thetransistor/OpenWest2017/images/render_back.png

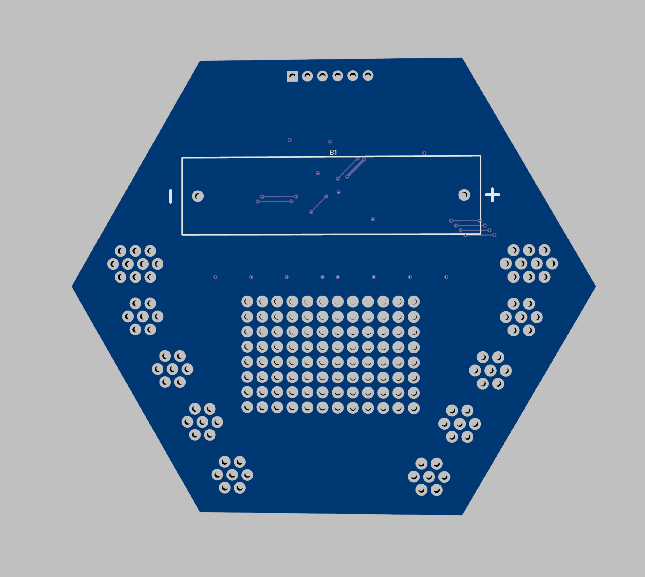
images/render_back.png
