thetransistor/OpenWest2017/images/render_front.png

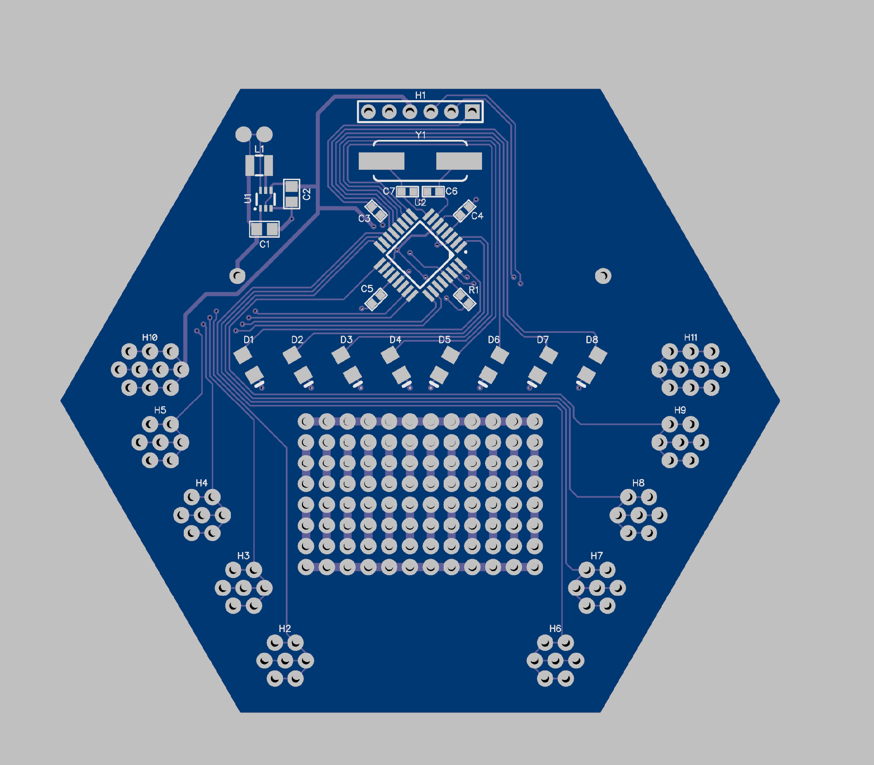
images/render_front.png
