thetransistor/OpenWest2017/(threads)

Thread 2 (2017-07-17):

Binary Clock in OoenWest Badge 2017 dumps program

TDStanleyPhD, 2017-07-17:
I built the binary clock Thursday.  It worked fine most of the day, but dumped the flashing later in the day as the battery failed.  I had it re-flashed on Friday and it worked through Sunday when it dumped the programming again.  i wanted to use it for a demonstration Thursday at the Governors Native American Conference on Thursday.  Is there a way to have it re-flashed or get the instructions on building a programmer and obtain the image to download?

Thanks,

Tim

d3c4f, 2017-07-17:
I'll figure something out tonight and get back to you.

Thanks,
d3c4f

On Jul 16, 2017 21:04, "TDStanleyPhD" <notifications@github.com> wrote:

I built the binary clock Thursday. It worked fine most of the day, but
dumped the flashing later in the day as the battery failed. I had it
re-flashed on Friday and it worked through Sunday when it dumped the
programming again. i wanted to use it for a demonstration Thursday at the
Governors Native American Conference on Thursday. Is there a way to have it
re-flashed or get the instructions on building a programmer and obtain the
image to download?

Thanks,

Tim

—
You are receiving this because you are subscribed to this thread.
Reply to this email directly, view it on GitHub
<https://github.com/thetransistor/OpenWest2017/issues/2>, or mute the thread
<https://github.com/notifications/unsubscribe-auth/ABq3D37cZt6PODT9bWzS_W-E67aNhT5_ks5sOs9XgaJpZM4OZgpU>
.

TDStanleyPhD, 2017-07-17:
I should have mentioned that I am in Orem, and would be happy to run it over for the short time it takes to flash.

Tim

Sent from my iPad

On Jul 17, 2017, at 10:46 AM, d3c4f <notifications@github.com<mailto:notifications@github.com>> wrote:

I'll figure something out tonight and get back to you.

Thanks,
d3c4f

On Jul 16, 2017 21:04, "TDStanleyPhD" <notifications@github.com<mailto:notifications@github.com>> wrote:

I built the binary clock Thursday. It worked fine most of the day, but
dumped the flashing later in the day as the battery failed. I had it
re-flashed on Friday and it worked through Sunday when it dumped the
programming again. i wanted to use it for a demonstration Thursday at the
Governors Native American Conference on Thursday. Is there a way to have it
re-flashed or get the instructions on building a programmer and obtain the
image to download?

Thanks,

Tim

—
You are receiving this because you are subscribed to this thread.
Reply to this email directly, view it on GitHub
<https://github.com/thetransistor/OpenWest2017/issues/2>, or mute the thread
<https://github.com/notifications/unsubscribe-auth/ABq3D37cZt6PODT9bWzS_W-E67aNhT5_ks5sOs9XgaJpZM4OZgpU>
.

—
You are receiving this because you authored the thread.
Reply to this email directly, view it on GitHub<https://github.com/thetransistor/OpenWest2017/issues/2#issuecomment-315807556>, or mute the thread<https://github.com/notifications/unsubscribe-auth/Ac0prGm76vWn2o6qqN8Qhg0xfa4ACSX0ks5sO466gaJpZM4OZgpU>.

d3c4f, 2017-07-18:
Mike,

Could you maybe coordinate and see if you have time to help flash this
badge again? I'm out of time prepping for BlackHat over the next couple
days.

Thanks,
d3c4f

On Mon, Jul 17, 2017 at 1:20 PM, TDStanleyPhD <notifications@github.com>
wrote:

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

compukidmike, 2017-07-18:
Tim, I'm happy to refresh your badge. Send me an email at compukidmike@gmail.com so we can work out the details.
-Michael

TDStanleyPhD, 2017-07-18:
Michael,

Thanks for the note and agreeing to refresh my badge.  Where and when works best for you?

Tim Stanley
Phone. 801-607-1929
Email.   Timothy.stanley@uvu.edu<mailto:Timothy.stanley@uvu.edu>

Sent from my iPad

On Jul 17, 2017, at 7:31 PM, compukidmike <notifications@github.com<mailto:notifications@github.com>> wrote:

Tim, I'm happy to refresh your badge. Send me an email at compukidmike@gmail.com<mailto:compukidmike@gmail.com> so we can work out the details.
-Michael

—
You are receiving this because you authored the thread.
Reply to this email directly, view it on GitHub<https://github.com/thetransistor/OpenWest2017/issues/2#issuecomment-315931926>, or mute the thread<https://github.com/notifications/unsubscribe-auth/Ac0prO4cO7lQetXSAuH1nLJZdBUogdMuks5sPAragaJpZM4OZgpU>.

Thread 3 (2017-10-10):

Missing instructions for volunteer LED ribbons

mbniebergall, 2017-10-10:
As a volunteer I received a sweet LED ribbon with components to solder. I have my LED ribbon kit and soldering iron ready to go, but there are no instructions or diagrams on how to solder it up. I have scoured the Internet without any luck, probably because I don't know what exactly to search for.

Could the instructions for the volunteer LED ribbons please be added?
