thetransistor/OpenWest2017/(list of files, drawings)

Other design files:
hardware/layout.dip
hardware/schematic.dch
